ahmed24630/AeroQuad/README.md

# AeroQuad
Arduino based drone using arduino AeroQuad Shield

please use this repo for the code:

https://github.com/AeroQuad/AeroQuad
