ahmed24630/AeroQuad/Documentation/Architecture/Version 2.0/AeroQuadFlightSoftwareArchitecture_v2.0.pptx

FlightCommand

AeroQuad.h

Receiver.h

DataAcquisition.h

FlightAngle.h

DataStorage.h

AeroQuad

Filter.h

Compass.h

Sensors

Accel.h

Distance.h

Gyro.h

Altitude.h

SerialCom

GPS.h

FlightControl

PID.h

Motors.h
