ahmed24630/AeroQuad/Documentation/Architecture/AeroQuadSoftwareFlowDiagram.png

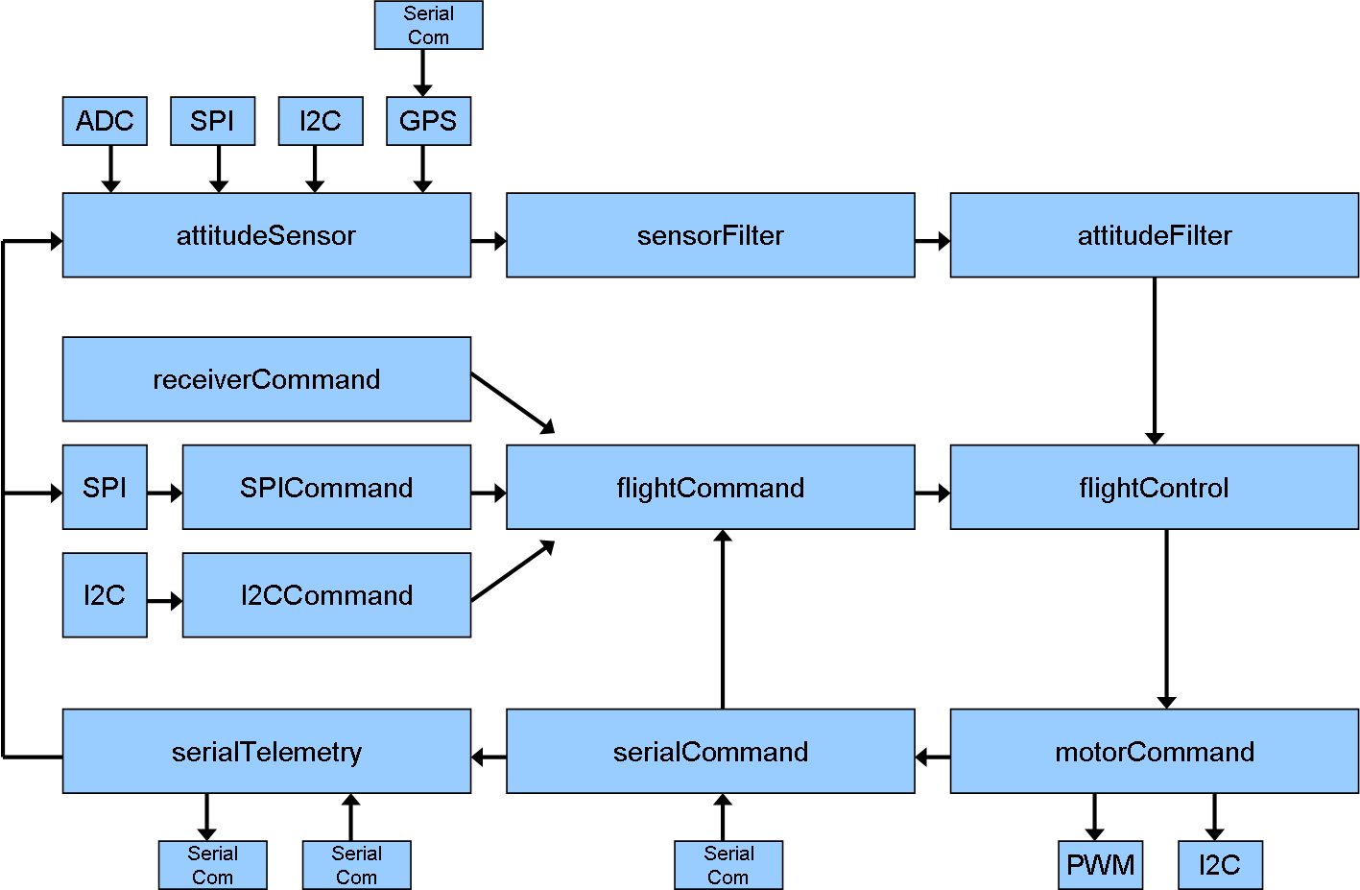
Documentation/Architecture/AeroQuadSoftwareFlowDiagram.png
