ahmed24630/AeroQuad/FlightControlBoards/AQ32_v2/AQ32_v2_BOM.xlsx

Item # | Qty | Ref Des | Description | Package | Value | Device
1 | 3 | R39, R40, R58 | Resistor | R0402 | 0R | R-US_R0402
2 | 6 | R1, R2, R8, R52, R60, R64 | Resistor | R0402 | 10k | RESISTOR0402
3 | 19 | R5, R7, R14, R15, R16, R17, R18, R19, R20, R21, R22, R23, R24, R25, R29, R30, R31, R32, R36 | Resistor | R0402 | 1k | RESISTOR0402
4 | 2 | R3, R61 | Resistor | R0402 | 1k5 | R-US_R0402
5 | 4 | R9, R10, R12, R13 | Resistor | R0402 | 1k69 | RESISTOR0402
6 | 1 | R62 | Resistor | R0402 | 220R | RESISTOR0402
7 | 2 | R26, R35 | Resistor | R0402 | 22R | RESISTOR0402
8 | 4 | R4, R6, R11, R57 | Resistor | R0402 | 330 | RESISTOR0402
9 | 7 | R27, R28, R33, R34, R48, R49, R53 | Resistor | R0402 | 4k7 | RESISTOR0402
10 | 13 | C2, C4, C6, C8, C10, C12, C15, C17, C22, C29, C39, C40, C45 | Capacitor | C0402 | 0.1uF | CAP0402
11 | 1 | C21 | Capacitor | C0402 | 0.22uF | CAP0402
12 | 1 | C18 | Capacitor | C0402 | 10nF | CAP0402
13 | 1 | C43 | Capacitor | C0805 | 10uF | C-USC0805
14 | 2 | C3, C11 | Capacitor Polarized | EIA3216 | 10uF | CAP_POL1206
15 | 1 | C9 | Capacitor Polarized | EIA3216 | 10uF (25V) | CAP_POL1206
16 | 2 | C14, C16 | Capacitor | C0402 | 1uF | CAP0402
17 | 2 | C20, C24 | Capacitor Polarized | SMC_Z | 1uF (ESR) | CPOL-USSMCZ
18 | 1 | C7 | Capacitor | C0402 | 2.2nF | CAP0402
19 | 2 | C41, C54 | Capacitor | C0402 | 2.2uF | CAP0402
20 | 1 | C1 | Capacitor Polarized | SMC_Z | 4.7uF | CPOL-USSMCZ
21 | 1 | C42 | Capacitor | C0805 | 47uF | C-USC0805
22 | 2 | D2, D3 | Diode | SOD-323 | 30V | DIODESOD
23 | 1 | L1 | Inductors | 805 | 100uH | INDUCTOR0805
24 | 1 | XT | Resonator | RESONATOR-SMD | 8MHz | RESONATORSMD
25 | 4 | Q2, Q3, Q5, Q6 | Transistor NPN | SOT23-3 | BCV27 | TRANSISTOR_NPNSOT23-3
26 | 3 | LED1, LED3, LED4 | LEDs | LED-0603 | Blue | LED0603
27 | 1 | LED2 | LEDs | LED-0603 | Green | LED0603
28 | 2 | U3, U13 | 2-input EXCLUSIV-OR gate | SC70-5 | 74AHC1G86DCK | 74AHC1G86DCK
29 | 1 | U9 | 3 Axis Digital Compass IC | 16LPCC | HMC5983-TR | HMC5983-TR
30 | 1 | U11 | LDO 3.3V Volt Reg | TO-223 | MIC5239 | MIC5239
31 | 2 | I2C, SERIAL | Disconnectable Crimp style connector, 1.0mm pitch4 contacts | SM04B-SRSS-TB | SM04B-SRSS-TB | SM04B-SRSS-TB
32 | 1 | GPS | Disconnectable Crimp style connector, 1.0mm pitch6 contacts | SM06B-SRSS-TB | SM06B-SRSS-TB | SM06B-SRSS-TB
33 | 1 | OSD | Disconnectable Crimp style connector, 1.0mm pitch7 contacts | SM07B-SRSS-TB | SM07B-SRSS-TB | SM07B-SRSS-TB
34 | 1 | U2 | STM32F407VGT6 | TQFP100 | STM32F407VGT6 | STM32F407VGT6
35 | 1 | S1 | SWITCH TACTILE SPST-NO 0.05A 12V | TACTILE_SWITCH_SMD | SW-MOM | SWITCH-MOMENTARY-2SMD
36 | 1 | X2 | Mini USB Connector | CONN USB MINI B R/A SMD | USB-M26FTR | USB-M26FTR
37 | 1 | U7 | microSD Socket | MICRO-SD-SOCKET-PP | USD-SOCKETNEW | USD-SOCKETNEW
38 | 1 | JP1 | 2x8 Right Angle Male Header | 2x08 | JP1 | M08LOCK
39 | 1 | JP3-1, JP3-2 | Do Not Install | Do Not Install | Do Not Install | Do Not Install
40 | 1 | JP4-1, JP4-2 | Do Not Install | Do Not Install | Do Not Install | Do Not Install
41 | 2 | JP5 | Do Not Install | Do Not Install | Do Not Install | Do Not Install
42 | 2 | C5, C44 | Do Not Install | Do Not Install | Do Not Install | Do Not Install
43 | 2 | R37, R38, R45 | Do Not Install | Do Not Install | Do Not Install | Do Not Install
44 | 1 | JP2 | 3x12 Right Angle Male Header | 3x12 | M12LOCK | M12LOCK
45 | 1 | U1 | MPU-6000 6DOF IMU | QFN-24 | MPU-6000 | MPU-6000
46 | 1 | U10 | Pressure sensor 10cm | LGA08A | MS5611 | MS5611
