ahmed24630/AeroQuad/Documentation/Frame/v3.0/AeroQuadFrame_v3.dxf

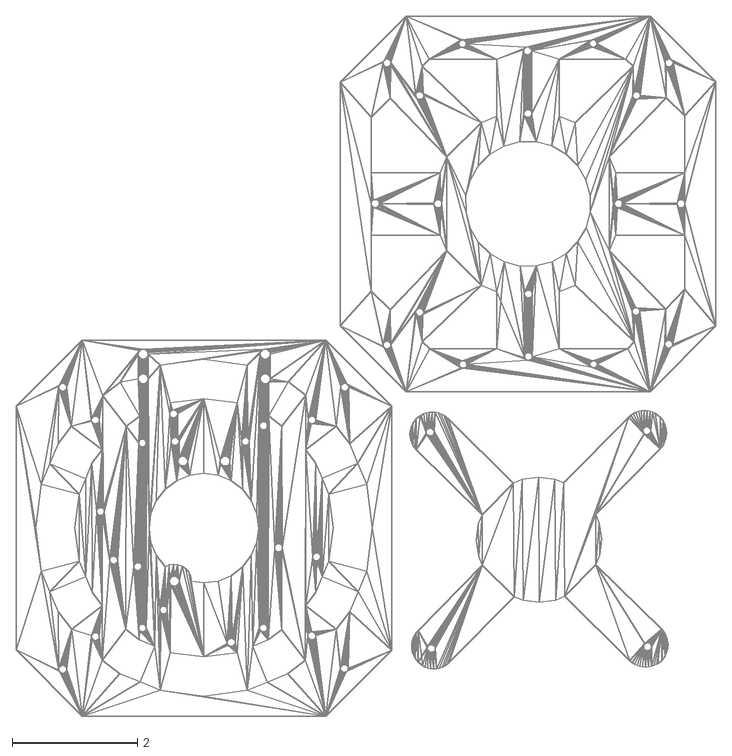
[picture p4: CAD file, 2022-06-11]
Documentation/Frame/v3.0/AeroQuadFrame_v3.dxf
11.2 x 11.2
