ahmed24630/AeroQuad/Documentation/InterconnectDiagram/v1.7/AeroQuadInterconnectDiagram_v1.7.pdf

# 11.1V LIPO

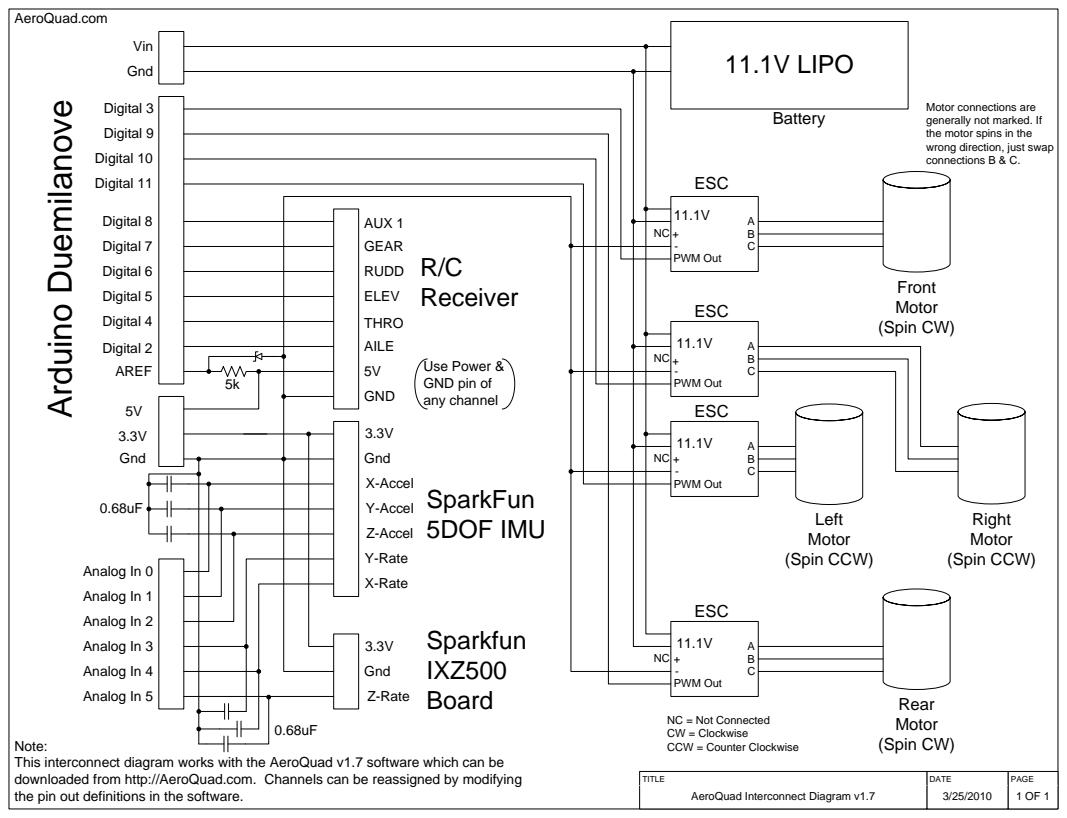
[picture p6: page 1]
PAGE 1 OF 1 DATE; 3/25/2010 TITLE; AeroQuad Interconnect Diagram v1.7; AeroQuad.com; Analog In 0; Analog In 1; Analog In 2; Analog In 3; Analog In 4; Analog In 5; Gnd; Vin; uin; mila; X-Accel; Z-Accel; Y-Accel; Y-Rate; X-Rate; SparkFun 5DOF IMU; Z-Rate; Sparkfun IXZ500 Board; AREF; Digital 2; Digital 4; Digital 5; Digital 6; Digital 7; Digital 8; Digital 11; Digital 10; Digital 9; Digital 3; AUX 1; GEAR; GND; Front Motor (Spin CW); Rear Motor (Spin CW); Right Motor (Spin CCW)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

Battery
the motor spins in the wrong direction, just swap connections B & C. A

Motor connections are generally not marked. If

R/C RUDD Receiver ELEV THRO AILE Use Power & 5V

GND pin of
any channel

NC = Not Connected
CW = Clockwise CCW = Counter Clockwise

Note:
This interconnect diagram works with the AeroQuad v1.7 software which can be
downloaded from http://AeroQuad.com. Channels can be reassigned by modifying
the pin out definitions in the software.
