ahmed24630/AeroQuad/FlightControlBoards/AeroQuad_v2.1/AeroQuad_v210_Shield.pdf

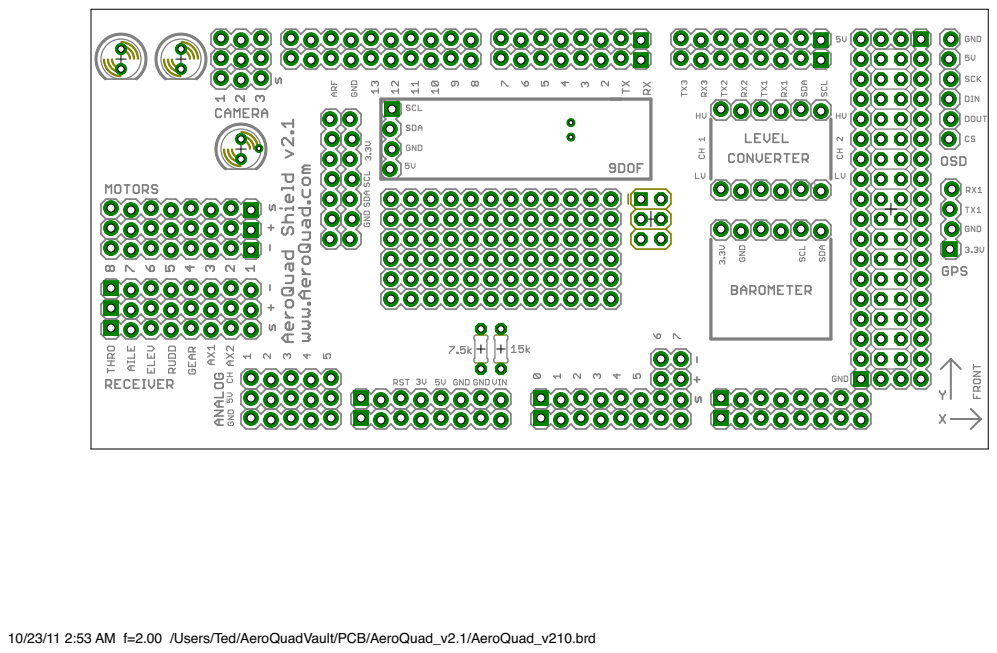
[picture p8: page 1]

10/23/11 2:53 AM f=2.00 /Users/Ted/AeroQuadVault/PCB/AeroQuad_v2.1/AeroQuad_v210.brd
