ahmed24630/AeroQuad/Documentation/InterconnectDiagram/v1.1/AeroQuadInterconnectDiagram_v1.1.pdf

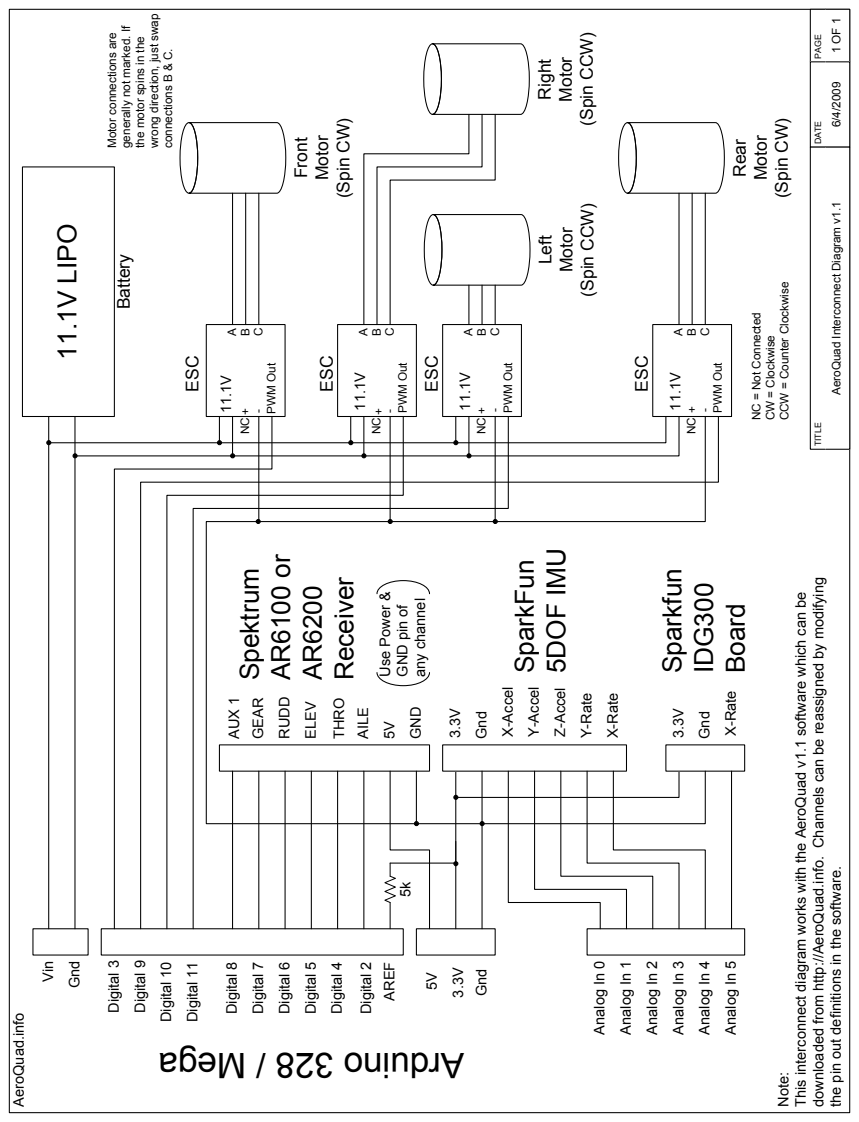
[picture p9: page 1]
PAGE; DATE; TITLE; Note:; AeroQuad.info; Analog In 0; Analog In 1; Analog In 2; Analog In 3; Analog In 4; Analog In 5; Gnd; Vin; X-Accel; Y-Accel; Z-Accel; Y-Rate; X-Rate; SparkFun; 5DOF IMU; Sparkfun; IDG300; Board; AREF; Digital 8; Digital 7; Digital 6; Digital 5; Digital 4; Digital 2; Digital 10; Digital 11; Digital 3; Digital 9; Spektrum; Receiver; AUX 1; GEAR; RUDD; ELEV; THRO; AILE; GND; Use Power &; any channel; Front; Motor; (Spin CW); Rear; Right; (Spin CCW); Left; 11.1V LIPO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

wrong direction, just swap

Motor connections are

generally not marked. If

the motor spins in the

AeroQuad Interconnect Diagram v1.1

CCW = Counter Clockwise

NC = Not Connected

downloaded from http://AeroQuad.info. Channels can be reassigned by modifying

This interconnect diagram works with the AeroQuad v1.1 software which can be

GND pin of

the pin out definitions in the software.
