ahmed24630/AeroQuad/FlightControlBoards/AeroQuad_v2.0.6/AeroQuad_v206.pdf

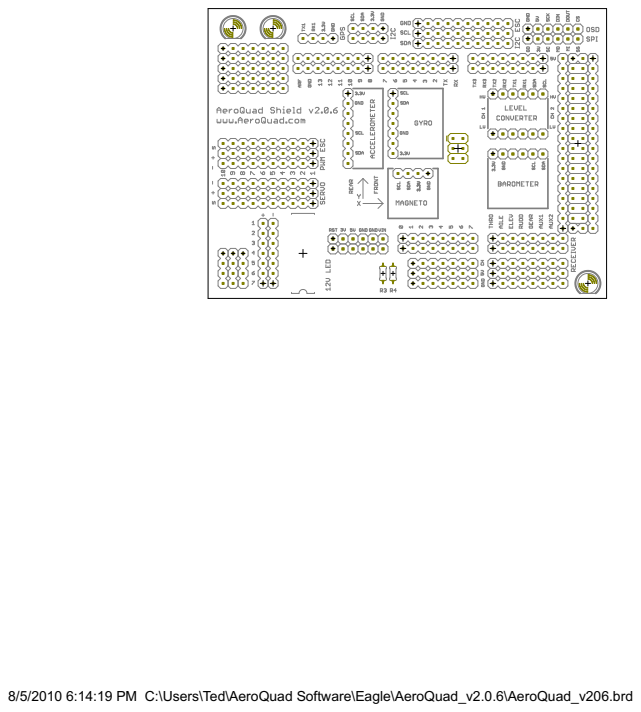
[picture p12: page 1]

8/5/2010 6:14:19 PM C:\Users\Ted\AeroQuad Software\Eagle\AeroQuad_v2.0.6\AeroQuad_v206.brd
