ahmed24630/AeroQuad/FlightControlBoards/AeroQuad_v1.8/AeroQuad_v18.pdf

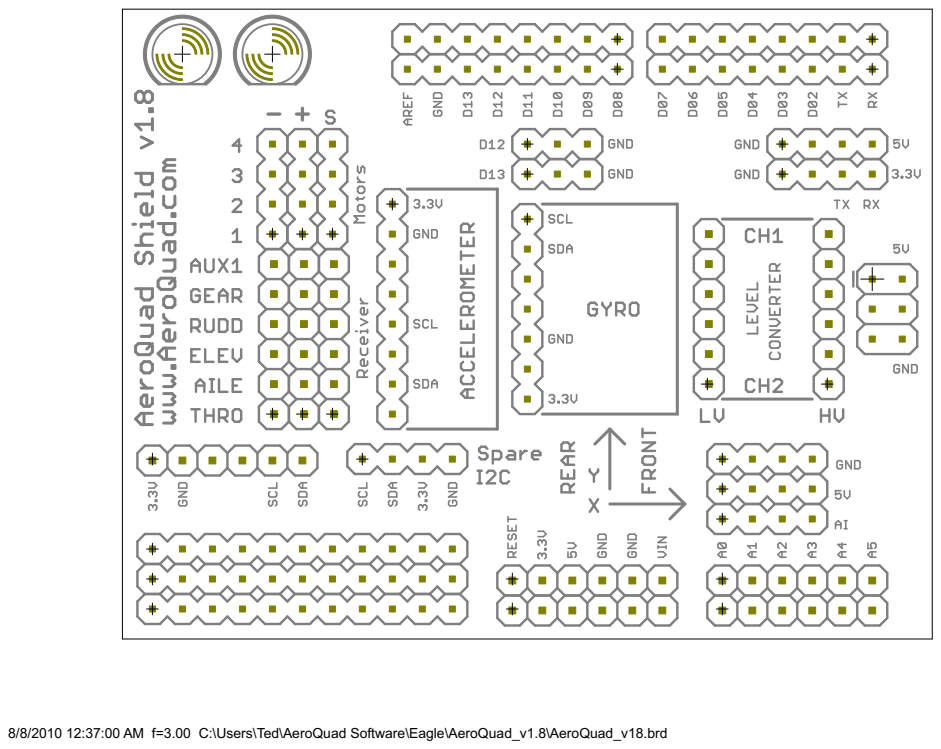
[picture p13: page 1]

8/8/2010 12:37:00 AM f=3.00 C:\Users\Ted\AeroQuad Software\Eagle\AeroQuad_v1.8\AeroQuad_v18.brd
