ahmed24630/AeroQuad/FlightControlBoards/AeroQuad_v2.1.3/AeroQuad_v213.brd

## EAGLE design FlightControlBoards/AeroQuad_v2.1.3/AeroQuad_v213.brd (2022-06-11, an earlier design)

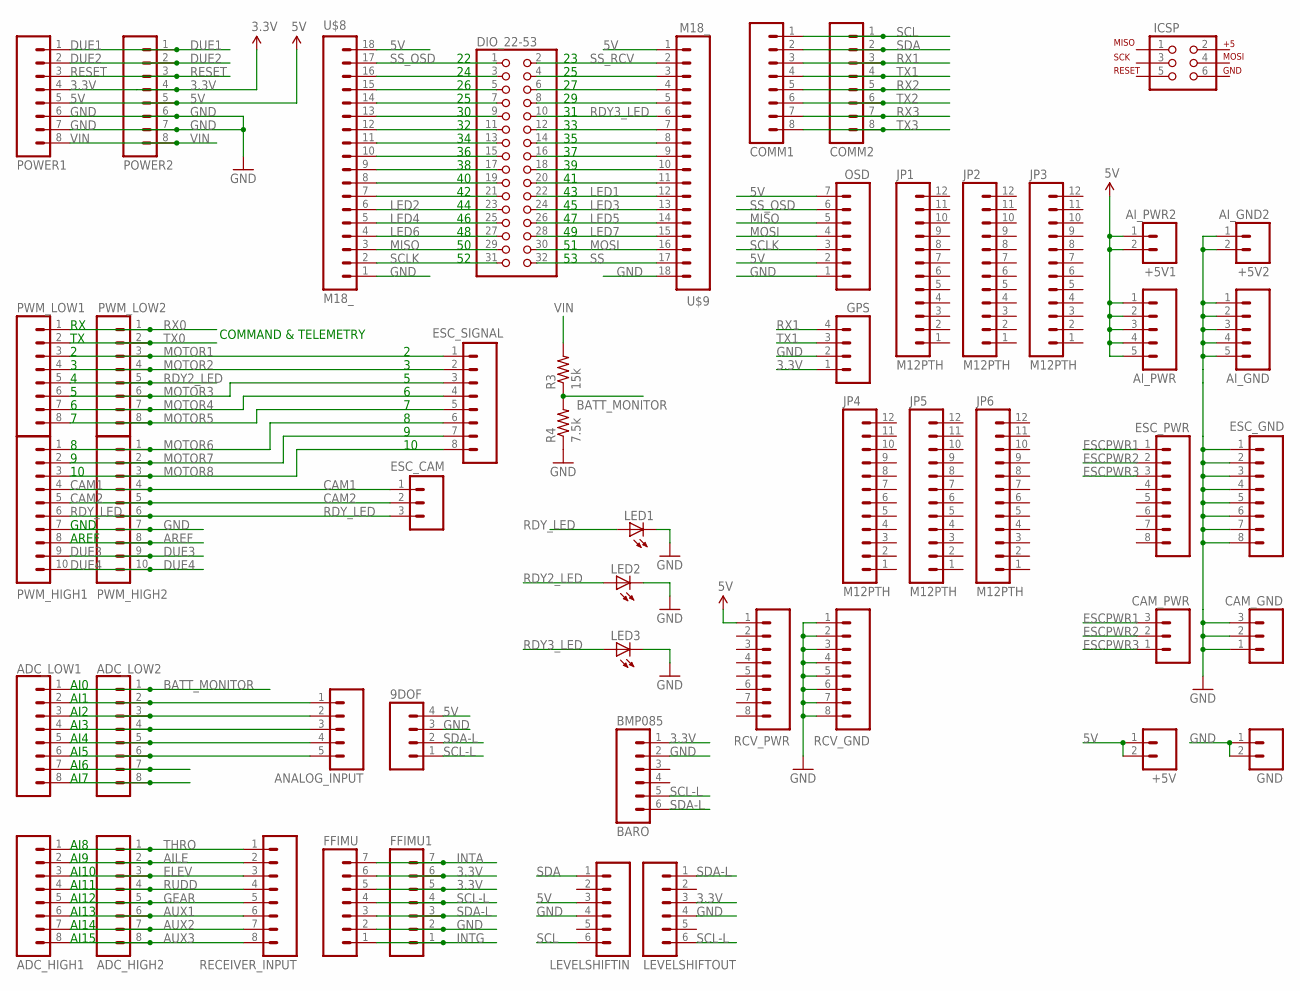
[picture p15: schematic AeroQuad_v213.sch]

Parts:
9DOF: M04LOCK; 1X04_LOCK
+5V: M02PTH; 1X02
+5V1: AI_PWR2; 1X02
+5V2: AI_GND2; 1X02
ADC_HIGH1, ADC_HIGH2: M08LOCK; 1X08_LOCK
ADC_LOW1, ADC_LOW2: M08LOCK; 1X08_LOCK
AI_GND: M05LOCK; 1X05_LOCK
AI_PWR: M05LOCK; 1X05_LOCK
ANALOG_INPUT: M05LOCK; 1X05_LOCK
BARO: BMP085; 1X06_LOCK
CAM_GND: M03LOCK; 1X03_LOCK
CAM_PWR: M03LOCK; 1X03_LOCK
COMM1, COMM2: M08LOCK; 1X08_LOCK
DIO_22-53: PINHD-2X16; 2X16
ESC_CAM: M03LOCK; 1X03_LOCK
ESC_GND: M10LOCK; 1X08_LOCK
ESC_PWR: M10LOCK; 1X08_LOCK
ESC_SIGNAL: M10LOCK; 1X08_LOCK
FFIMU, FFIMU1: M07LOCK; 1X07_LOCK
GND: M02PTH; 1X02
GPS: M04LOCK; 1X04_LOCK
ICSP: AVR_SPI_PRG_6NS; 2X3-NS
JP1, JP2, JP3, JP4, JP5, JP6: M12PTH; 1X12
LED1, LED2, LED3: LED5MM
LEVELSHIFTIN: M06LOCK; 1X06_LOCK
LEVELSHIFTOUT: M06LOCK; 1X06_LOCK
OSD: M07LOCK; 1X07_LOCK
POWER1, POWER2: M08LOCK; 1X08_LOCK
PWM_HIGH1, PWM_HIGH2: M10LOCK; 1X10_LOCK
PWM_LOW1, PWM_LOW2: M08LOCK; 1X08_LOCK
R3: 15k; 0204/5
R4: 7.5k; 0204/5
RCV_GND: M10LOCK; 1X08_LOCK
RCV_PWR: M10LOCK; 1X08_LOCK
RECEIVER_INPUT: M08LOCK; 1X08_LOCK
U$8, U$9: M18_; 1X18

Connections:
3.3V: BARO.1, FFIMU.5, FFIMU.6, FFIMU1.5, FFIMU1.6, GPS.1, LEVELSHIFTOUT.3, POWER1.4, POWER2.4
5V: 9DOF.4, +5V.1, +5V.2, +5V1.1, +5V1.2, AI_PWR.1, AI_PWR.2, AI_PWR.3, AI_PWR.4, AI_PWR.5, LEVELSHIFTIN.3, OSD.2, OSD.7, POWER1.5, POWER2.5, RCV_PWR.1, U$8.18, U$9.1
AILE: ADC_HIGH1.2, ADC_HIGH2.2, RECEIVER_INPUT.2
AREF: PWM_HIGH1.8, PWM_HIGH2.8
AUX1: ADC_HIGH1.6, ADC_HIGH2.6, RECEIVER_INPUT.6
AUX2: ADC_HIGH1.7, ADC_HIGH2.7, RECEIVER_INPUT.7
AUX3: ADC_HIGH1.8, ADC_HIGH2.8, RECEIVER_INPUT.8
BATT_MONITOR: ADC_LOW1.1, ADC_LOW2.1, R3.1, R4.2
CAM1: ESC_CAM.1, PWM_HIGH1.4, PWM_HIGH2.4
CAM2: ESC_CAM.2, PWM_HIGH1.5, PWM_HIGH2.5
DUE1: POWER1.1, POWER2.1
DUE2: POWER1.2, POWER2.2
DUE3: PWM_HIGH1.9, PWM_HIGH2.9
DUE4: PWM_HIGH1.10, PWM_HIGH2.10
ELEV: ADC_HIGH1.3, ADC_HIGH2.3, RECEIVER_INPUT.3
ESCPWR1: CAM_PWR.3, ESC_PWR.1
ESCPWR2: CAM_PWR.2, ESC_PWR.2
ESCPWR3: CAM_PWR.1, ESC_PWR.3
GEAR: ADC_HIGH1.5, ADC_HIGH2.5, RECEIVER_INPUT.5
GND: 9DOF.3, +5V2.1, +5V2.2, AI_GND.1, AI_GND.2, AI_GND.3, AI_GND.4, AI_GND.5, BARO.2, CAM_GND.1, CAM_GND.2, CAM_GND.3, ESC_GND.1, ESC_GND.2, ESC_GND.3, ESC_GND.4, ESC_GND.5, ESC_GND.6, ESC_GND.7, ESC_GND.8, FFIMU.2, FFIMU1.2, GND.1, GND.2, GPS.2, LED1.K (C), LED2.K (C), LED3.K (C), LEVELSHIFTIN.4, LEVELSHIFTOUT.4, OSD.1, POWER1.6, POWER1.7, POWER2.6, POWER2.7, PWM_HIGH1.7, PWM_HIGH2.7, R4.1, RCV_GND.1, RCV_GND.2, RCV_GND.3, RCV_GND.4, RCV_GND.5, RCV_GND.6, RCV_GND.7, RCV_GND.8, U$8.1, U$9.18
INTA: FFIMU.7, FFIMU1.7
INTG: FFIMU.1, FFIMU1.1
LED1: DIO_22-53.22, U$9.12
LED2: DIO_22-53.23, U$8.6
LED3: DIO_22-53.24, U$9.13
LED4: DIO_22-53.25, U$8.5
LED5: DIO_22-53.26, U$9.14
LED6: DIO_22-53.27, U$8.4
LED7: DIO_22-53.28, U$9.15
MISO: DIO_22-53.29, OSD.5, U$8.3
MOSI: DIO_22-53.30, OSD.4, U$9.16
MOTOR1: ESC_SIGNAL.1, PWM_LOW1.3, PWM_LOW2.3
MOTOR2: ESC_SIGNAL.2, PWM_LOW1.4, PWM_LOW2.4
MOTOR3: ESC_SIGNAL.3, PWM_LOW1.6, PWM_LOW2.6
MOTOR4: ESC_SIGNAL.4, PWM_LOW1.7, PWM_LOW2.7
MOTOR5: ESC_SIGNAL.5, PWM_LOW1.8, PWM_LOW2.8
MOTOR6: ESC_SIGNAL.6, PWM_HIGH1.1, PWM_HIGH2.1
MOTOR7: ESC_SIGNAL.7, PWM_HIGH1.2, PWM_HIGH2.2
MOTOR8: ESC_SIGNAL.8, PWM_HIGH1.3, PWM_HIGH2.3
unnamed: DIO_22-53.11, U$8.12
unnamed: DIO_22-53.9, U$8.13
unnamed: DIO_22-53.7, U$8.14
unnamed: ADC_LOW1.2, ADC_LOW2.2, ANALOG_INPUT.1
unnamed: ADC_LOW1.3, ADC_LOW2.3, ANALOG_INPUT.2
unnamed: ADC_LOW1.4, ADC_LOW2.4, ANALOG_INPUT.3
unnamed: ADC_LOW1.5, ADC_LOW2.5, ANALOG_INPUT.4
unnamed: ADC_LOW1.6, ADC_LOW2.6, ANALOG_INPUT.5
unnamed: DIO_22-53.3, U$8.16
unnamed: ADC_LOW1.7, ADC_LOW2.7
unnamed: ADC_LOW1.8, ADC_LOW2.8
unnamed: DIO_22-53.5, U$8.15
unnamed: DIO_22-53.4, U$9.3
unnamed: DIO_22-53.6, U$9.4
unnamed: DIO_22-53.8, U$9.5
RDY2_LED: LED2.A, PWM_LOW1.5, PWM_LOW2.5
RDY3_LED: DIO_22-53.10, LED3.A, U$9.6
RDY_LED: ESC_CAM.3, LED1.A, PWM_HIGH1.6, PWM_HIGH2.6
RESET: POWER1.3, POWER2.3
RUDD: ADC_HIGH1.4, ADC_HIGH2.4, RECEIVER_INPUT.4
RX0: PWM_LOW1.1, PWM_LOW2.1
RX1: COMM1.3, COMM2.3, GPS.4
RX2: COMM1.5, COMM2.5
RX3: COMM1.7, COMM2.7
SCL: COMM1.1, COMM2.1, LEVELSHIFTIN.6
SCL-L: 9DOF.1, BARO.5, FFIMU.4, FFIMU1.4, LEVELSHIFTOUT.6
SCLK: DIO_22-53.31, OSD.3, U$8.2
SDA: COMM1.2, COMM2.2, LEVELSHIFTIN.1
SDA-L: 9DOF.2, BARO.6, FFIMU.3, FFIMU1.3, LEVELSHIFTOUT.1
SERVO1: DIO_22-53.12, U$9.7
SERVO2: DIO_22-53.13, U$8.11
SERVO3: DIO_22-53.14, U$9.8
SERVO4: DIO_22-53.15, U$8.10
SERVO5: DIO_22-53.16, U$9.9
SERVO6: DIO_22-53.17, U$8.9
SERVO7: DIO_22-53.18, U$9.10
SERVO8: DIO_22-53.19, U$8.8
SERVO9: DIO_22-53.20, U$9.11
SERVO10: DIO_22-53.21, U$8.7
SS: DIO_22-53.32, U$9.17
SS_OSD: DIO_22-53.1, OSD.6, U$8.17
SS_RCV: DIO_22-53.2, U$9.2
THRO: ADC_HIGH1.1, ADC_HIGH2.1, RECEIVER_INPUT.1
TX0: PWM_LOW1.2, PWM_LOW2.2
TX1: COMM1.4, COMM2.4, GPS.3
TX2: COMM1.6, COMM2.6
TX3: COMM1.8, COMM2.8
VIN: POWER1.8, POWER2.8, R3.2

Notes on the sheet:
GND
AREF
AI0
AI1
AI2
AI3
AI4
AI5
AI6
AI7
AI8
AI9
AI10
AI11
AI12
AI13
AI14
AI15
COMMAND & TELEMETRY

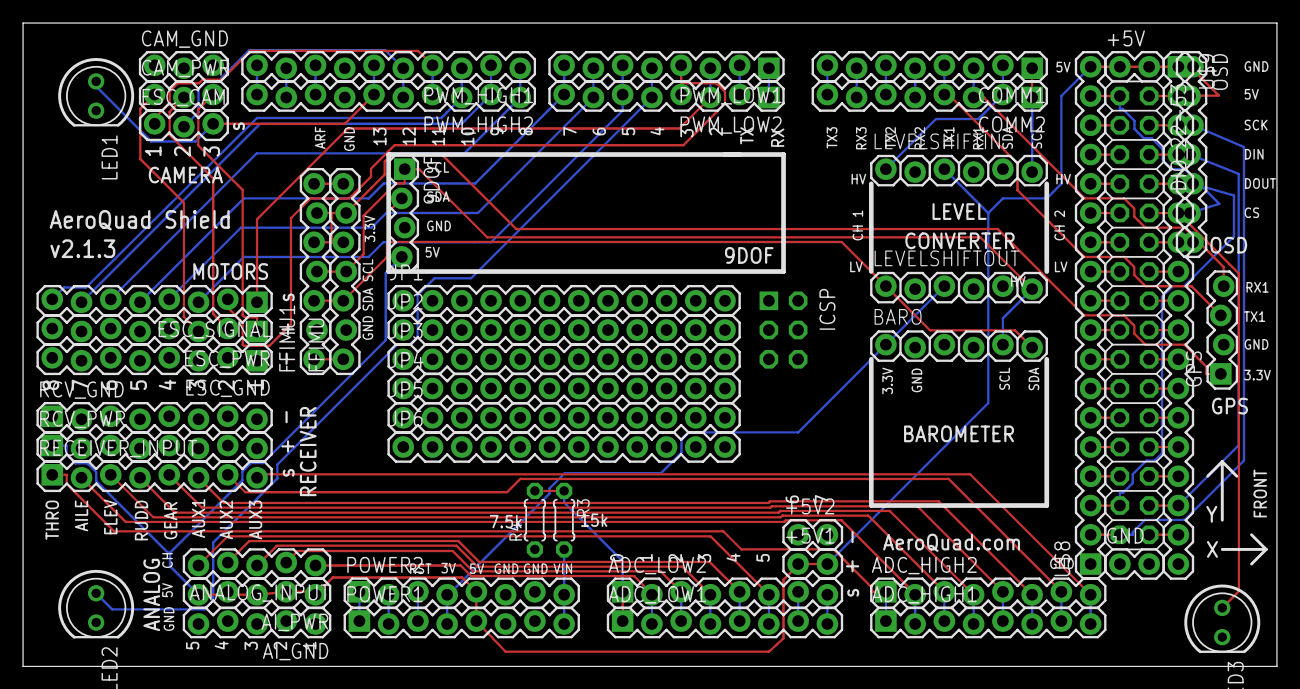
[picture p16: board AeroQuad_v213.brd from above]

Board: 2 copper layers, 108.9 x 55.9 mm, 51 parts (0 on the bottom side), 87 nets.
