ahmed24630/AeroQuad/FlightControlBoards/AeroQuad_v3.0/AeroQuad_v300.brd

## EAGLE design FlightControlBoards/AeroQuad_v3.0/AeroQuad_v300.brd (2022-06-11)

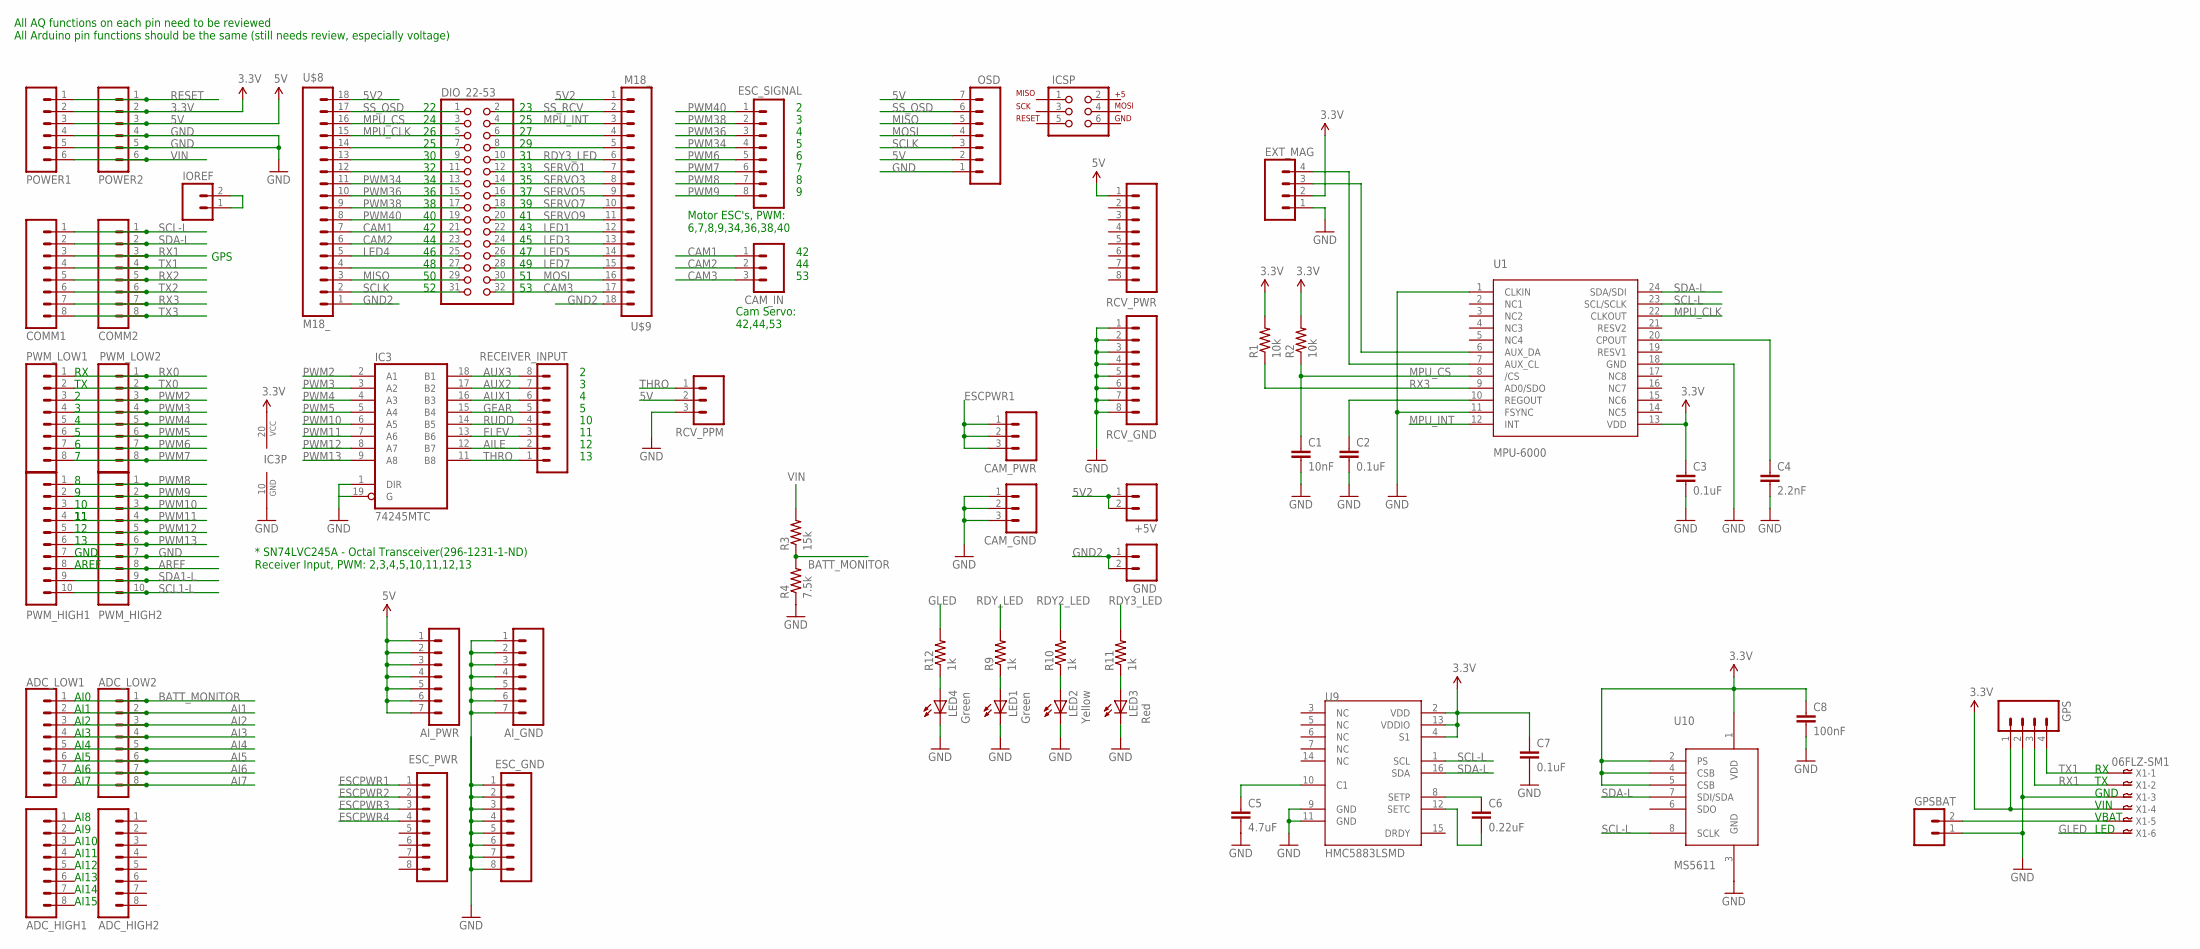
[picture p20: schematic AeroQuad_v300.sch]

Parts:
+5V: M02PTH; 1X02
ADC_HIGH1, ADC_HIGH2: M08LOCK; 1X08_LOCK
ADC_LOW1, ADC_LOW2: M08LOCK; 1X08_LOCK
AI_GND: M07; 1X07
AI_PWR: M07; 1X07
C1: 10nF; 0402-CAP
C2, C3, C7: 0.1uF; 0402-CAP
C4: 2.2nF; 0402-CAP
C5: 4.7uF; 0402-CAP
C6: 0.22uF; 0402-CAP
C8: 100nF; 0402-CAP
CAM_GND: M03LOCK; 1X03_LOCK
CAM_IN: M03LOCK; 1X03_LOCK
CAM_PWR: M03LOCK; 1X03_LOCK
COMM1, COMM2: M08LOCK; 1X08_LOCK
DIO_22-53: PINHD-2X16; 2X16
ESC_GND: M11LOCK; 1X08_LOCK
ESC_PWR: M11LOCK; 1X08_LOCK
ESC_SIGNAL: M11LOCK; 1X08_LOCK
EXT_MAG: M04LOCK; 1X04_LOCK
GND: M02PTH; 1X02
GPS: M04LOCK; 1X04_LOCK
GPSBAT: M02PTH; 1X02
IC3: 74245MTC; SSOP20
ICSP: AVR_SPI_PRG_6NS; 2X3-NS
IOREF: M02LOCK; 1X02_LOCK
LED1, LED4: Green; LED-0603
LED2: Yellow; LED-0603
LED3: Red; LED-0603
OSD: M07LOCK; 1X07_LOCK
POWER1, POWER2: M06LOCK; 1X06_LOCK
PWM_HIGH1, PWM_HIGH2: M10LOCK; 1X10_LOCK
PWM_LOW1, PWM_LOW2: M08LOCK; 1X08_LOCK
R1, R2: 10k; 0402-RES
R3: 15k; 0402-RES
R4: 7.5k; 0402-RES
R9, R10, R11, R12: 1k; 0402-RES
RCV_GND: M10LOCK; 1X08_LOCK
RCV_PPM: M03LOCK; 1X03_LOCK
RCV_PWR: M10LOCK; 1X08_LOCK
RECEIVER_INPUT: M08LOCK; 1X08_LOCK
U1: MPU-6000; QFN-24
U9: HMC5883LSMD; 16LPCC
U10: MS5611; LGA08A
U$8, U$9: M18_; 1X18
X1: 06FLZ-SM1; 6FLZ-SM

Connections:
3.3V: C3.1, C7.1, C8.1, EXT_MAG.2, GPS.1, IC3.20 (VCC), POWER1.2, POWER2.2, R1.2, R2.2, U1.13 (VDD), U9.2 (VDD), U9.4 (S1), U9.13 (VDDIO), U10.1 (VDD), U10.2 (PS), U10.4 (CSB), U10.5 (CSB), X1.4
5V: AI_PWR.1, AI_PWR.2, AI_PWR.3, AI_PWR.4, AI_PWR.5, AI_PWR.6, AI_PWR.7, OSD.2, OSD.7, POWER1.3, POWER2.3, RCV_PPM.2, RCV_PWR.1
5V2: +5V.1, +5V.2, U$8.18, U$9.1
AI1: ADC_LOW1.2, ADC_LOW2.2
AI2: ADC_LOW1.3, ADC_LOW2.3
AI3: ADC_LOW1.4, ADC_LOW2.4
AI4: ADC_LOW1.5, ADC_LOW2.5
AI5: ADC_LOW1.6, ADC_LOW2.6
AI6: ADC_LOW1.7, ADC_LOW2.7
AI7: ADC_LOW1.8, ADC_LOW2.8
AILE: IC3.12 (B7), RECEIVER_INPUT.2
AREF: PWM_HIGH1.8, PWM_HIGH2.8
AUX1: IC3.16 (B3), RECEIVER_INPUT.6
AUX2: IC3.17 (B2), RECEIVER_INPUT.7
AUX3: IC3.18 (B1), RECEIVER_INPUT.8
BATT_MONITOR: ADC_LOW1.1, ADC_LOW2.1, R3.1, R4.2
CAM1: CAM_IN.1, DIO_22-53.21, U$8.7
CAM2: CAM_IN.2, DIO_22-53.23, U$8.6
CAM3: CAM_IN.3, DIO_22-53.32, U$9.17
ELEV: IC3.13 (B6), RECEIVER_INPUT.3
ESCPWR1: CAM_PWR.1, CAM_PWR.2, CAM_PWR.3, ESC_PWR.1
ESCPWR2: ESC_PWR.2
ESCPWR3: ESC_PWR.3
ESCPWR4: ESC_PWR.4
GEAR: IC3.15 (B4), RECEIVER_INPUT.5
GLED: R12.2, X1.6
GND: AI_GND.1, AI_GND.2, AI_GND.3, AI_GND.4, AI_GND.5, AI_GND.6, AI_GND.7, C1.2, C2.2, C3.2, C4.2, C5.2, C7.2, C8.2, CAM_GND.1, CAM_GND.2, CAM_GND.3, ESC_GND.1, ESC_GND.2, ESC_GND.3, ESC_GND.4, ESC_GND.5, ESC_GND.6, ESC_GND.7, ESC_GND.8, EXT_MAG.1, GPS.2, GPSBAT.1, IC3.1 (DIR), IC3.10 (GND), IC3.19 (G), LED1.C, LED2.C, LED3.C, LED4.C, OSD.1, POWER1.4, POWER1.5, POWER2.4, POWER2.5, PWM_HIGH1.7, PWM_HIGH2.7, R4.1, RCV_GND.1, RCV_GND.2, RCV_GND.3, RCV_GND.4, RCV_GND.5, RCV_GND.6, RCV_GND.7, RCV_GND.8, RCV_PPM.3, U1.1 (CLKIN), U1.11 (FSYNC), U1.18 (GND), U9.9 (GND), U9.11 (GND), U10.3 (GND), X1.3
GND2: GND.1, GND.2, U$8.1, U$9.18
LED1: DIO_22-53.22, U$9.12
LED3: DIO_22-53.24, U$9.13
LED4: DIO_22-53.25, U$8.5
LED5: DIO_22-53.26, U$9.14
LED7: DIO_22-53.28, U$9.15
MISO: DIO_22-53.29, OSD.5, U$8.3
MOSI: DIO_22-53.30, OSD.4, U$9.16
MPU_CLK: DIO_22-53.5, U1.22 (CLKOUT), U$8.15
MPU_CS: C1.1, DIO_22-53.3, R2.1, U1.8 (/CS), U$8.16
MPU_INT: DIO_22-53.4, U1.12 (INT), U$9.3
unnamed: DIO_22-53.11, U$8.12
unnamed: DIO_22-53.9, U$8.13
unnamed: DIO_22-53.7, U$8.14
unnamed: LED4.A, R12.1
unnamed: DIO_22-53.27, U$8.4
unnamed: GPSBAT.2, X1.5
unnamed: LED1.A, R9.1
unnamed: LED2.A, R10.1
unnamed: LED3.A, R11.1
unnamed: C5.1, U9.10 (C1)
unnamed: EXT_MAG.4, U1.7 (AUX_CL)
unnamed: EXT_MAG.3, U1.6 (AUX_DA)
unnamed: IOREF.1, IOREF.2
unnamed: C6.1, U9.8 (SETP)
unnamed: C6.2, U9.12 (SETC)
unnamed: C2.1, U1.10 (REGOUT)
unnamed: DIO_22-53.6, U$9.4
unnamed: DIO_22-53.8, U$9.5
unnamed: C4.1, U1.20 (CPOUT)
PWM2: IC3.2 (A1), PWM_LOW1.3, PWM_LOW2.3
PWM3: IC3.3 (A2), PWM_LOW1.4, PWM_LOW2.4
PWM4: IC3.4 (A3), PWM_LOW1.5, PWM_LOW2.5
PWM5: IC3.5 (A4), PWM_LOW1.6, PWM_LOW2.6
PWM6: ESC_SIGNAL.5, PWM_LOW1.7, PWM_LOW2.7
PWM7: ESC_SIGNAL.6, PWM_LOW1.8, PWM_LOW2.8
PWM8: ESC_SIGNAL.7, PWM_HIGH1.1, PWM_HIGH2.1
PWM9: ESC_SIGNAL.8, PWM_HIGH1.2, PWM_HIGH2.2
PWM10: IC3.6 (A5), PWM_HIGH1.3, PWM_HIGH2.3
PWM11: IC3.7 (A6), PWM_HIGH1.4, PWM_HIGH2.4
PWM12: IC3.8 (A7), PWM_HIGH1.5, PWM_HIGH2.5
PWM13: IC3.9 (A8), PWM_HIGH1.6, PWM_HIGH2.6
PWM34: DIO_22-53.13, ESC_SIGNAL.4, U$8.11
PWM36: DIO_22-53.15, ESC_SIGNAL.3, U$8.10
PWM38: DIO_22-53.17, ESC_SIGNAL.2, U$8.9
PWM40: DIO_22-53.19, ESC_SIGNAL.1, U$8.8
RDY2_LED: R10.2
RDY3_LED: DIO_22-53.10, R11.2, U$9.6
RDY_LED: R9.2
RESET: POWER1.1, POWER2.1
RUDD: IC3.14 (B5), RECEIVER_INPUT.4
RX0: PWM_LOW1.1, PWM_LOW2.1
RX1: COMM1.3, COMM2.3, GPS.3, X1.2
RX2: COMM1.5, COMM2.5
RX3: COMM1.7, COMM2.7, R1.1, U1.9 (AD0/SDO)
SCL1-L: PWM_HIGH1.10, PWM_HIGH2.10
SCL-L: COMM1.1, COMM2.1, U1.23 (SCL/SCLK), U9.1 (SCL), U10.8 (SCLK)
SCLK: DIO_22-53.31, OSD.3, U$8.2
SDA1-L: PWM_HIGH1.9, PWM_HIGH2.9
SDA-L: COMM1.2, COMM2.2, U1.24 (SDA/SDI), U9.16 (SDA), U10.7 (SDI/SDA)
SERVO1: DIO_22-53.12, U$9.7
SERVO3: DIO_22-53.14, U$9.8
SERVO5: DIO_22-53.16, U$9.9
SERVO7: DIO_22-53.18, U$9.10
SERVO9: DIO_22-53.20, U$9.11
SS_OSD: DIO_22-53.1, OSD.6, U$8.17
SS_RCV: DIO_22-53.2, U$9.2
THRO: IC3.11 (B8), RCV_PPM.1, RECEIVER_INPUT.1
TX0: PWM_LOW1.2, PWM_LOW2.2
TX1: COMM1.4, COMM2.4, GPS.4, X1.1
TX2: COMM1.6, COMM2.6
TX3: COMM1.8, COMM2.8
VIN: POWER1.6, POWER2.6, R3.2

Notes on the sheet:
GND
AREF
AI0
AI1
AI2
AI3
AI4
AI5
AI6
AI7
AI8
AI9
AI10
AI11
AI12
AI13
AI14
AI15
GPS
VIN
VBAT
LED
* SN74LVC245A - Octal Transceiver(296-1231-1-ND) Receiver Input, PWM: 2,3,4,5,10,11,12,13
Motor ESC's, PWM: 6,7,8,9,34,36,38,40
All AQ functions on each pin need to be reviewed All Arduino pin functions should be the same (still needs review, especially voltage)
Cam Servo: 42,44,53

Board: 2 copper layers, 60 parts (0 on the bottom side), 95 nets, no tracks yet.
