ahmed24630/AeroQuad/AeroQuad/Motors.h

/*
  AeroQuad v2.1 - October 2010
  www.AeroQuad.com
  Copyright (c) 2010 Ted Carancho.  All rights reserved.
  An Open Source Arduino based multicopter.
 
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
  You should have received a copy of the GNU General Public License 
  along with this program. If not, see <http://www.gnu.org/licenses/>. 
*/

class Motors {
public:
  // Assume maximum number of motors is 8, leave array indexes unused if lower number
  int motorAxisCommand[3];
  int motorAxisCommandRoll[8];
  int motorAxisCommandPitch[8];
  int motorAxisCommandYaw[8];
  int motorMixerSettingRoll[8];
  int motorMixerSettingPitch[8];
  int motorMixerSettingYaw[8];
  int motorCommand[8];
  int minCommand[8];
  int maxCommand[8];
  float throttle;
  float timerDebug;
  int motor;
  int delta;
  byte axis;
  // Ground station control
  int remoteCommand[8];
  float mMotorCommand;
  float bMotorCommand;


  Motors(void){
    throttle = 0;
    motorAxisCommand[ROLL] = 0;
    motorAxisCommand[PITCH] = 0;
    motorAxisCommand[YAW] = 0;
    for (motor = 0; motor < 8; motor++) {
      motorAxisCommandRoll[motor] = 0;
      motorAxisCommandPitch[motor] = 0;
      motorAxisCommandYaw[motor] = 0;
      motorMixerSettingRoll[motor] = 0;
      motorMixerSettingPitch[motor] = 0;
      motorMixerSettingYaw[motor] = 0;
      motorCommand[motor] = 1000;
      minCommand[motor] = MINCOMMAND;
      maxCommand[motor] = MAXCOMMAND;
      remoteCommand[motor] = 1000;
    }
    motor = 0;
    delta = 0;  
  };
  
  // The following function calls must be defined in any new subclasses
  virtual void initialize(void);
  virtual void write (void);
  virtual void commandAllMotors(int motorCommand);
  
  //Any number of optional methods can be configured as needed by the SubSystem to expose functionality externally
  void pulseMotors(byte quantity) {
    for (byte i = 0; i < quantity; i++) {      
      commandAllMotors(MINCOMMAND + 100);
      delay(250);
      commandAllMotors(MINCOMMAND);
      delay(250);
    }
  }
  
  void setRemoteCommand(byte motor, int value) {
    remoteCommand[motor] = value;
  }
  
  const int getRemoteCommand(byte motor) {
    return remoteCommand[motor];
  }
  
  const float getMotorSlope(void) {
    return mMotorCommand;
  }
  
  const float getMotorOffset(void) {
    return bMotorCommand;
  }
    
  void setMinCommand(byte motor, int value) {
    minCommand[motor] = value;
  }
  
  const int getMinCommand(byte motor) {
    return minCommand[motor];
  }
  
  void setMaxCommand(byte motor, int value) {
    maxCommand[motor] = value;
  }
  
  const int getMaxCommand(byte motor) {
    return maxCommand[motor];
  }
  
  void setMotorAxisCommand(byte motor, int value) {
    motorAxisCommand[motor] = value;
  }
  
  const int getMotorAxisCommand(byte motor) {
    return motorAxisCommand[motor];
  }
  
  void setMotorCommand(byte motor, int value) {
    motorCommand[motor] = value;
  }
  
  const int getMotorCommand(byte motor) {
    return motorCommand[motor];
  }
  void setThrottle(float value) {
    throttle = value;
  }
  const float getThrottle() {
    return throttle;
  }
};

/******************************************************/
/********************* PWM Motors *********************/
/******************************************************/
class Motors_PWM : public Motors {
private:
  #if defined(AeroQuadMega_v2) || defined(AeroQuadMega_Wii)
    #define FRONTMOTORPIN 2
    #define REARMOTORPIN 3
    #define RIGHTMOTORPIN 5
    #define LEFTMOTORPIN 6
    #define LASTMOTORPIN 7
  #else
    #define FRONTMOTORPIN 3
    #define REARMOTORPIN 9
    #define RIGHTMOTORPIN 10
    #define LEFTMOTORPIN 11
    #define LASTMOTORPIN 12
  #endif  
  int minCommand;
  byte pin;
  
 public:
  Motors_PWM() : Motors(){
    // Scale motor commands to analogWrite
    // Only supports commands from 0-255 => 0 - 100% duty cycle
    // Usable pulsewith from approximately 1000-2000 us = 126 - 250	
    // m = (250-126)/(2000-1000) = 0.124		
    // b = y1 - (m * x1) = 126 - (0.124 * 1000) = 2		
    mMotorCommand = 0.124;		
    bMotorCommand = 2.0;
  }

  void initialize(void) {
    pinMode(FRONTMOTORPIN, OUTPUT);
    analogWrite(FRONTMOTORPIN, 124);		
    pinMode(REARMOTORPIN, OUTPUT);
    analogWrite(REARMOTORPIN, 124);		
    pinMode(RIGHTMOTORPIN, OUTPUT);
    analogWrite(RIGHTMOTORPIN, 124);		
    pinMode(LEFTMOTORPIN, OUTPUT);
  }

  void write(void) {
    analogWrite(FRONTMOTORPIN, (motorCommand[FRONT] * mMotorCommand) + bMotorCommand);
    analogWrite(REARMOTORPIN, (motorCommand[REAR] * mMotorCommand) + bMotorCommand);
    analogWrite(RIGHTMOTORPIN, (motorCommand[RIGHT] * mMotorCommand) + bMotorCommand);
    analogWrite(LEFTMOTORPIN, (motorCommand[LEFT] * mMotorCommand) + bMotorCommand);
  }
  
  void commandAllMotors(int _motorCommand) {   // Sends commands to all motors
    analogWrite(FRONTMOTORPIN, (_motorCommand * mMotorCommand) + bMotorCommand);
    analogWrite(REARMOTORPIN, (_motorCommand * mMotorCommand) + bMotorCommand);		
    analogWrite(RIGHTMOTORPIN, (_motorCommand * mMotorCommand) + bMotorCommand);		
    analogWrite(LEFTMOTORPIN, (_motorCommand * mMotorCommand) + bMotorCommand);
  }
};

/******************************************************/
/***************** ArduCopter Motors ******************/
/******************************************************/
#ifdef ArduCopter
class Motors_ArduCopter : public Motors {
public:
  Motors_ArduCopter() : Motors() {}

  void initialize(void) {
    // Init PWM Timer 1
    //pinMode(11,OUTPUT); //     (PB5/OC1A)
    pinMode(12,OUTPUT); //OUT2 (PB6/OC1B)
    pinMode(13,OUTPUT); //OUT3 (PB7/OC1C)
  
    //Remember the registers not declared here remains zero by default... 
    TCCR1A =((1<<WGM11)|(1<<COM1B1)|(1<<COM1C1)); //Please read page 131 of DataSheet, we are changing the registers settings of WGM11,COM1B1,COM1A1 to 1 thats all... 
    TCCR1B = (1<<WGM13)|(1<<WGM12)|(1<<CS11); //Prescaler set to 8, that give us a resolution of 0.5us, read page 134 of data sheet
    //OCR1A = 3000; //PB5, none
    OCR1B = 3000; //PB6, OUT2
    OCR1C = 3000; //PB7  OUT3
    ICR1 = 6600; //300hz freq...
  
    // Init PWM Timer 3
    pinMode(2,OUTPUT); //OUT7 (PE4/OC3B)
    pinMode(3,OUTPUT); //OUT6 (PE5/OC3C)
    //pinMode(4,OUTPUT); //     (PE3/OC3A)
    TCCR3A =((1<<WGM31)|(1<<COM3B1)|(1<<COM3C1));
    TCCR3B = (1<<WGM33)|(1<<WGM32)|(1<<CS31); 
    //OCR3A = 3000; //PE3, NONE
    OCR3B = 3000; //PE4, OUT7
    OCR3C = 3000; //PE5, OUT6
    ICR3 = 40000; //50hz freq (standard servos)
  
    // Init PWM Timer 5
    pinMode(44,OUTPUT);  //OUT1 (PL5/OC5C)
    pinMode(45,OUTPUT);  //OUT0 (PL4/OC5B)
    //pinMode(46,OUTPUT);  //     (PL3/OC5A)
    
    TCCR5A =((1<<WGM51)|(1<<COM5B1)|(1<<COM5C1)); 
    TCCR5B = (1<<WGM53)|(1<<WGM52)|(1<<CS51);
    //OCR5A = 3000; //PL3, 
    OCR5B = 3000; //PL4, OUT0
    OCR5C = 3000; //PL5, OUT1
    ICR5 = 6600; //300hz freq
  
    // Init PPM input and PWM Timer 4
    pinMode(49, INPUT);  // ICP4 pin (PL0) (PPM input)
    pinMode(7,OUTPUT);   //OUT5 (PH4/OC4B)
    pinMode(8,OUTPUT);   //OUT4 (PH5/OC4C)
        
    TCCR4A =((1<<WGM40)|(1<<WGM41)|(1<<COM4C1)|(1<<COM4B1)|(1<<COM4A1));  
    //Prescaler set to 8, that give us a resolution of 0.5us
    // Input Capture rising edge
    TCCR4B = ((1<<WGM43)|(1<<WGM42)|(1<<CS41)|(1<<ICES4));
    
    OCR4A = 40000; ///50hz freq. (standard servos)
    OCR4B = 3000; //PH4, OUT5
    OCR4C = 3000; //PH5, OUT4
   
    //TCCR4B |=(1<<ICES4); //Changing edge detector (rising edge). 
    //TCCR4B &=(~(1<<ICES4)); //Changing edge detector. (falling edge)
    TIMSK4 |= (1<<ICIE4); // Enable Input Capture interrupt. Timer interrupt mask
  }

  void write (void) {
    OCR1B = motorCommand[FRONT] * 2;
    OCR1C = motorCommand[REAR] * 2;
    OCR5B = motorCommand[RIGHT] * 2;
    OCR5C = motorCommand[LEFT] * 2;
  }

  void commandAllMotors(int _motorCommand) {   // Sends commands to all motors
    OCR1B = _motorCommand * 2;
    OCR1C = _motorCommand * 2;
    OCR5B = _motorCommand * 2;
    OCR5C = _motorCommand * 2;
  }
};
#endif

/*************************************************************/
/********************* Multipilot Motors *********************/
/*************************************************************/
#ifdef MultipilotI2C
class Motors_I2C : public Motors {
public:


/* Mixertable VAR */
  float MotorGas[LASTMOTOR];
  float MotorPitch[LASTMOTOR];
  float MotorRoll[LASTMOTOR];
  float MotorYaw[LASTMOTOR];
  float motorAxisCommandPitch[LASTMOTOR];
  float motorAxisCommandRoll[LASTMOTOR];
  float motorAxisCommandYaw[LASTMOTOR];
  
  unsigned char MotorI2C[LASTMOTOR];	
  Motors_I2C() : Motors() {}

  void initialize(void) {
  char Motor[LASTMOTOR];		
  // Scale motor commands to analogWrite		
  // m = (250-126)/(2000-1000) = 0.124		
  // b = y1 - (m * x1) = 126 - (0.124 * 1000) = 2		
  //float mMotorCommand = 0.124;		
  //float bMotorCommand = 2 ;
  
  mMotorCommand = 0.255;		
  bMotorCommand = -255;
  timer_debug=0;
  
  //motorCommand[8] = {1000,1000,1000,1000,1000,1000,1000,1000};

  //int subtrim[4] = {1500,1500,1500,1500};    //SUBTRIM li esprimo in millisecondi come i servi per standardizzazione. 
  //motorAxisCommand[3] = {0,0,0};
  
  // If AREF = 3.3V, then A/D is 931 at 3V and 465 = 1.5V 
  // Scale gyro output (-465 to +465) to motor commands (1000 to 2000) 
  // use y = mx + b 
  //mMotorRate = 1.0753; // m = (y2 - y1) / (x2 - x1) = (2000 - 1000) / (465 - (-465)) 
  //bMotorRate = 1500;   // b = y1 - m * x1
  init_mixer_table(); // Init MixerTable
  Wire.begin(0x29);
 }

// C'e' im
#ifdef HEXARADIAL
void init_mixer_table()
{
// Example for Hexa configuration
MotorGas[0] = 100;
MotorPitch[0] = -100;  
MotorRoll[0] =  0;  
MotorYaw[0] =  100;  

MotorGas[1] = 100;
MotorPitch[1] = -50;  
MotorRoll[1] =  -100;  
MotorYaw[1] =  -100;  

MotorGas[2] = 100;
MotorPitch[2] = +50  ; 
MotorRoll[2] =  -100;  
MotorYaw[2] =  100;  

MotorGas[3] = 100;
MotorPitch[3] =  +100;  
MotorRoll[3] =  0;  
MotorYaw[3] =  -100;  

MotorGas[4] = 100;
MotorPitch[4] = +50;  
MotorRoll[4] =  100;  
MotorYaw[4] =  100;  

MotorGas[5] = 100;
MotorPitch[5] =  -50;  
MotorRoll[5] =  100;  
MotorYaw[5] =  -100;  
}
#endif

// Example of Hexa Coaxial.
//Configurazione Motori Hexa Coaxial

//Dietro 			GAS		NICK		        ROLL		        YAW
//Sopra 1         		64		-64			0			-64
//Sotto 2			76		-64			0			64

//Guardando l'Hexafox da dietro braccio  Sinistro
//Sopra 3			64		32			64			64
//Sotto 4			76		32			64			-64

//Guardando l'Hexafox da dietro braccio  Destro.

//Sopra 5			64		32			-64			64
//Sotto 6			76		32			-64			-64


#ifdef HEXACOAXIAL
void init_mixer_table()
{
// Example for Hexa configuration
MotorGas[0] = 95;
MotorPitch[0] = 100;  
MotorRoll[0] =  0;  
MotorYaw[0] =  100; 

MotorGas[1] = 100;
MotorPitch[1] = 100;  
MotorRoll[1] =  0;  
MotorYaw[1] =  -100;  

MotorGas[2] = 95;
MotorPitch[2] = -50  ; 
MotorRoll[2] =  100;  
MotorYaw[2] =  -100;  

MotorGas[3] = 100;
MotorPitch[3] =  -50;  
MotorRoll[3] =  100;  
MotorYaw[3] =  100;  

MotorGas[4] = 95;
MotorPitch[4] = -50;  
MotorRoll[4] =  -100; 
MotorYaw[4] =  -100;  

MotorGas[5] = 100;
MotorPitch[5] =  -50;  
MotorRoll[5] =  -100;  
MotorYaw[5] =  100;  
}
#endif


void motor_axis_correction()
{
int i;
for (i=0;i<LASTMOTOR;i++)
  {
  motorAxisCommandPitch[i] = (motorAxisCommand[PITCH] / 100.0) * MotorPitch[i];
  motorAxisCommandRoll[i] = (motorAxisCommand[ROLL] / 100.0) * MotorRoll[i];
  motorAxisCommandYaw[i] = (motorAxisCommand[YAW] / 100.0) * MotorYaw[i];
  }
}

//After that we can mix them together:
void motor_matrix_command()
{
int i;
float valuemotor;
for (i=0;i<LASTMOTOR;i++)
  {
   valuemotor = ((Throttle* MotorGas[i])/100) + motorAxisCommandPitch[i] + motorAxisCommandYaw[i] + motorAxisCommandRoll[i];
   //valuemotor = Throttle + motorAxisCommandPitch[i] + motorAxisCommandYaw[i] + motorAxisCommandRoll[i]; // OLD VERSION WITHOUT GAS CONTROL ON Mixertable
   valuemotor = constrain(valuemotor, minAcro, MAXCOMMAND);
   motorCommand[i]=valuemotor;
  }
}


void matrix_debug()
{
#ifdef PRINT_MIXERTABLE 
     Serial.println();
     Serial.println("--------------------------");
     Serial.println("        Motori Mixertable " );
     Serial.println("--------------------------");
     Serial.println();

/*
     Serial.print("AIL:");
     Serial.print(ch1);
     Serial.print(" ELE:");
     Serial.print(ch2);
*/
     Serial.print(" THR:");
     Serial.print(Throttle);
/*
     Serial.print(" YAW:");
     Serial.print(ch4);
     Serial.print(" AUX:");
     Serial.print(ch_aux);
     Serial.print(" AUX2:");
     Serial.print(ch_aux2);
  */
     Serial.println();
     Serial.print("CONTROL_ROLL:");
     Serial.print(motorAxisCommand[ROLL]);
     Serial.print(" CONTROL_PITCH:");
     Serial.print(motorAxisCommand[PITCH]);
     Serial.print(" CONTROL_YAW:");
     Serial.print(motorAxisCommand[YAW]);
//     Serial.print(" SONAR_VALUE:");
//     Serial.print(sonar_value);
//     Serial.print(" TARGET_SONAR_VALUE:");
//     Serial.print(target_sonar_altitude);
//     Serial.print(" ERR_SONAR_VALUE:");
//     Serial.print(err_altitude);
//     Serial.println();
//     Serial.print("latitude:");
//     Serial.print(GPS_np.Lattitude);
//     Serial.print(" longitude:");
//     Serial.print(GPS_np.Longitude);
//     Serial.print(" command gps roll:");
//     Serial.print(command_gps_roll);
//     Serial.print(" command gps pitch:");
//     Serial.print(command_gps_pitch);
//     Serial.print(" Lon_diff:");
//     Serial.print(Lon_diff);
//     Serial.print(" Lon_diff");
//     Serial.print(command_gps_pitch);
 
//     Serial.println();
     
//     Serial.print("AP MODE:");Serial.print((int)AP_mode);

#ifdef ARDUCOPTER
     Serial.print("AIL:");
     Serial.print(ch1);
     Serial.print(" ELE:");
     Serial.print(ch2);
     Serial.print(" THR:");
     Serial.print(ch3);
     Serial.print(" YAW:");
     Serial.print(ch4);
     Serial.print(" AUX:");
     Serial.print(ch_aux);
     Serial.print(" AUX2:");
     Serial.print(ch_aux2);
     Serial.println();
     Serial.print("CONTROL_ROLL:");
     Serial.print(control_roll);
     Serial.print(" CONTROL_PITCH:");
     Serial.print(control_pitch);
     Serial.print(" CONTROL_YAW:");
     Serial.print(control_yaw);
     Serial.print(" SONAR_VALUE:");
     Serial.print(sonar_value);
     Serial.print(" TARGET_SONAR_VALUE:");
     Serial.print(target_sonar_altitude);
     Serial.print(" ERR_SONAR_VALUE:");
     Serial.print(err_altitude);
     Serial.println();
     Serial.print("latitude:");
     Serial.print(GPS_np.Lattitude);
     Serial.print(" longitude:");
     Serial.print(GPS_np.Longitude);
     Serial.print(" command gps roll:");
     Serial.print(command_gps_roll);
     Serial.print(" command gps pitch:");
     Serial.print(command_gps_pitch);
     Serial.print(" Lon_diff:");
     Serial.print(Lon_diff);
     Serial.print(" Lon_diff");
     Serial.print(command_gps_pitch);
 
     Serial.println();
     
     Serial.print("AP MODE:");Serial.print((int)AP_mode);
#endif

#ifdef HEXARADIAL
     Serial.println();
     Serial.print((unsigned int)MotorI2C[5]);
     comma();
     Serial.print((unsigned int)MotorI2C[0]);
     comma();
     Serial.print((unsigned int)MotorI2C[1]);
     comma();
     Serial.println();
     Serial.print((unsigned int)MotorI2C[4]);
     comma();
     Serial.print((unsigned int)MotorI2C[3]);
     comma();
     Serial.println((unsigned int)MotorI2C[2]);
     Serial.println("---------------");
     Serial.println();
#endif

// Example of Hexa Coaxial.
//Configurazione Motori Hexa Coaxial

//Dietro 			GAS		NICK		        ROLL		        YAW
//Sopra 1         		64		-64			0			-64
//Sotto 2			76		-64			0			64

//Guardando l'Hexafox da dietro braccio  Sinistro
//Sopra 3			64		32			64			64
//Sotto 4			76		32			64			-64

//Guardando l'Hexafox da dietro braccio  Destro.

//Sopra 5			64		32			-64			64
//Sotto 6			76		32			-64			-64


#ifdef HEXACOAXIAL
     Serial.println();
     Serial.print((unsigned int)MotorI2C[2]);
     comma();
     Serial.print((unsigned int)MotorI2C[4]);
     Serial.println();
     //comma();
     Serial.print((unsigned int)MotorI2C[3]);
     comma();
     Serial.print((unsigned int)MotorI2C[5]);
     Serial.println();
     Serial.print ("   ");
     //comma();
     Serial.print((unsigned int)MotorI2C[0]);
     Serial.println();
     Serial.print ("   ");
     //comma();
     Serial.println((unsigned int)MotorI2C[1]);
     Serial.println("---------------");
     Serial.println();
#endif

#endif
}

void WireMotorWrite()
{
int i = 0;
int nmotor=0;
int index=0;
int tout=0;
char buff_i2c[10];

Wire.endTransmission(); //end transmission
for(nmotor=0;nmotor<6;nmotor++)
  {
  index=0x29+nmotor;
  Wire.beginTransmission(index);
  Wire.send(MotorI2C[nmotor]); 
  Wire.endTransmission(); //end transmission
  Wire.requestFrom(index, 1);    // request 6 bytes from device
  i=0;
  while(1)   
  //while((Wire.available())&&(i<6))
  { 
    buff_i2c[i] = Wire.receive();  // receive one byte
    i++;
    if (i>6)break; 
    //Serial.print(i);
    if (Wire.available()==0)break;
  }
 
  }

}
  void write (void) {
    // Matrix transformation.
    motor_axis_correction();
    // Matrix Command.  
    motor_matrix_command();
   // Matrix Assignment. 
    MotorI2C[MOTORID1]=(char)((motorCommand[0] * mMotorCommand) + bMotorCommand); 
    MotorI2C[MOTORID2]=(char)((motorCommand[1] * mMotorCommand) + bMotorCommand);
    MotorI2C[MOTORID3]=(char)((motorCommand[2] * mMotorCommand) + bMotorCommand);
    MotorI2C[MOTORID4]=(char)((motorCommand[3] * mMotorCommand) + bMotorCommand);
    MotorI2C[MOTORID5]=(char)((motorCommand[4] * mMotorCommand) + bMotorCommand);
    MotorI2C[MOTORID6]=(char)((motorCommand[5] * mMotorCommand) + bMotorCommand); 
  
   if((millis()-timer_debug)>1000)   // 100ms => 10 Hz loop rate 
  {
    timer_debug=millis();
    #ifdef TELEMETRY_DEBUG
    matrix_debug();
    #endif     
}
   
 
    WireMotorWrite();
}

  void commandAllMotors(int _motorCommand) {   // Sends commands to all motors
    
    // Matrix transformation.
    motor_axis_correction();
    // Matrix Command.  
    motor_matrix_command();
   // Matrix Assignment. 
    MotorI2C[MOTORID1]=(char)((_motorCommand * mMotorCommand) + bMotorCommand);
    MotorI2C[MOTORID2]=(char)((_motorCommand * mMotorCommand) + bMotorCommand);
    MotorI2C[MOTORID3]=(char)((_motorCommand * mMotorCommand) + bMotorCommand);
    MotorI2C[MOTORID4]=(char)((_motorCommand * mMotorCommand) + bMotorCommand);
    MotorI2C[MOTORID5]=(char)((_motorCommand * mMotorCommand) + bMotorCommand);
    MotorI2C[MOTORID6]=(char)((_motorCommand * mMotorCommand) + bMotorCommand);
    matrix_debug();
    WireMotorWrite();
  }
};
#endif
