ahmed24630/AeroQuad/(commit log)

2022-06-11 initial version of AeroQuad project
    [12-5mmTubeMounts.skp, 12-7mmTubeMounts.skp, AeroQuadFrame3D_v2.1.skp, AeroQuadFrame_v2.0.skp, AeroQuadFrame_v2.1.skp, AeroQuadFrame_v3.dxf, AeroQuad_v14.brd, AeroQuad_v14.sch]
2022-06-11 added flight control boards
    [AQ32_v2.brd, AQ32_v2.sch, AQ32_v2_BOM.xlsx, AeroQuad32.brd, AeroQuad32.sch, AeroQuadMiniBare_v100.brd, AeroQuadMiniBare_v100.sch, AeroQuadMiniProto_v100.brd]
